Aminowm/pizzapitch/img/3d_rover.jpg

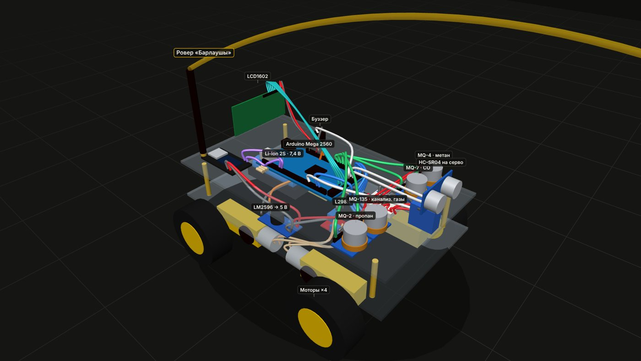
img/3d_rover.jpg
