Aminowm/pizzapitch/README.md

# Барлаушы — робот-разведчик газа

**Робот заходит первым. Человек — только когда безопасно.**
**Робот бірінші кіреді. Адам — тек қауіпсіз болғанда.**

Автономный ровер заезжает в канализационный колодец, коллектор, теплотрассу или подземную выработку раньше человека. Он меряет метан, угарный газ, канализационные газы и пропан и передаёт данные по LoRa на базу бригадира. Дальше данные идут в ноутбук по USB и на сайт через хотспот телефона. Если газ опасный, робот останавливается, включает сирену, отъезжает назад и ждёт решения человека.

Проект для **Pizza Pitch** (Ulytau Hub, Жезказган, 14 ноября 2026). Команда: Саян, Әмір, Әліби.

## Ссылки

| Что | Где |
|---|---|
| Сайт (лендинг + живая карточка) | https://aminowm.github.io/pizzapitch/ |
| Живой пульт (только просмотр) | https://aminowm.github.io/pizzapitch/live.html |
| Демо без железа | https://aminowm.github.io/pizzapitch/live.html#demo |
| Интерактивная 3D-схема | https://aminowm.github.io/pizzapitch/3d.html |
| QR-код на сайт | [`img/qr.png`](img/qr.png), карточка для жюри [`img/qr_card.png`](img/qr_card.png) |

## Что в репозитории

```
index.html, live.html, 3d.html, css/, js/, img/   сайт (GitHub Pages, корень репозитория)
firmware/rover_mega/rover_mega.ino                Arduino Mega: датчики MQ, моторы L298N, объезд, тревога, LCD
firmware/rover_lora/rover_lora.ino                LilyGO на ровере: мост Mega ↔ LoRa
firmware/base_lora/base_lora.ino                  LilyGO-база: LoRa → USB + Wi-Fi → MQTT → сайт
dashboard/index.html                              локальный пульт по USB (Chrome/Edge, без интернета)
docs/HARDWARE.md                                  схема подключения, питание, калибровка, план на 3 дня
docs/DEPLOY_SITE.md                               как включить сайт и проверить поток данных
docs/presentation_RU.pdf, presentation_KZ.pdf     презентация на русском и казахском
docs/idea_and_pitch_KZ.pdf                        жалпы идея, питч мәтіні, қиын сұрақтарға жауаптар
```

## Пины Arduino Mega (как собран робот)

| Что | Пины Mega |
|---|---|
| L298N | ENA=D5, IN1=D7, IN2=D8, IN3=D9, IN4=D10, ENB=D6 |
| MQ-4 / MQ-7 / MQ-135 / MQ-2 (AO) | A0 / A1 / A2 / A3 |
| Серво (сигнал) | D11 |
| HC-SR04 | TRIG=D12, ECHO=D13 |
| Буззер | D3 |
| LCD1602 с I2C | SDA=20, SCL=21 |
| LilyGO | TX1 (18) → делитель 3×10 кОм → GPIO34; LilyGO GPIO13 → RX1 (19) |

Питание: батарея 2S → L298N 12V → LM2596 (5,0 В на макетку: MQ, серво, HC-SR04, LCD, LilyGO) и Mega VIN. Общий GND.

## Как идут данные

1. Датчики MQ-4, MQ-7, MQ-135, MQ-2 → Arduino Mega (A0–A3)
2. Mega → LilyGO на ровере (UART, через делитель 5 → 3,3 В)
3. LoRa 433 МГц → LilyGO-база
4. База → ноутбук по USB (`dashboard/index.html`)
5. База → хотспот телефона «Barlaushy» → MQTT `broker.emqx.io`, канал `barlaushy/zhz1407`
6. Сайт подписан через WebSocket и обновляется в реальном времени

## Честно о прототипе

Датчики MQ недорогие, значения ppm оценочные, кислород они не измеряют. Прототип не является сертифицированным средством измерения. Промышленная версия: электрохимические сенсоры (O₂, H₂S, CO, CH₄), взрывозащищённый корпус, энкодеры, гусеницы, своё защищённое облако.
