Aminowm/pizzapitch/docs/presentation_KZ.pdf

P I Z Z A P I TC H · ЖЕ З Қ А З ҒА Н · 2 0 2 6 ЖЫ Л Ғ Ы 1 4
Қ А РА Ш А

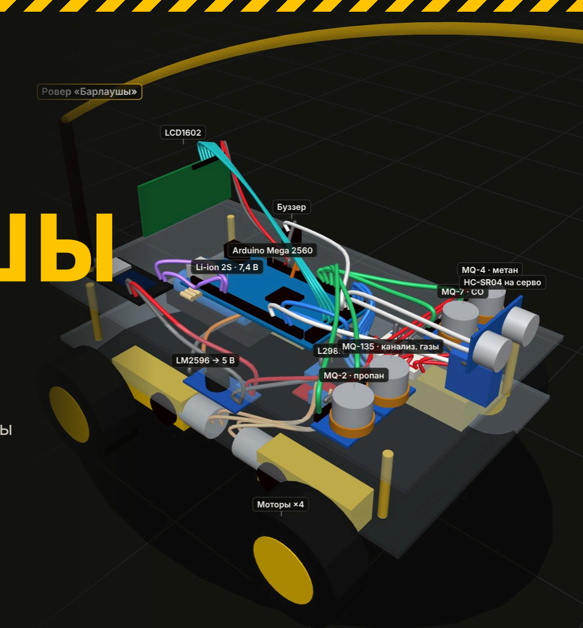
[picture p2: figure]

# БАРЛАУШЫ

Робот бірінші кіреді.
Адам — тек қауіпсіз болғанда.

Құдықтарға, коллекторларға және жерасты қазбаларына арналған автономды газ барлаушысы

Саян · Әмір · Әліби

Дереккөз: Kazinform · БАРЛАУШЫ · 2

ЖЕ З Қ А З ҒА Н · 2 0 2 6 ЖЫ Л Ғ Ы 2 0 М А М Ы Р · А Б А Й — Ч Е ХО В КӨ Ш Е Л Е Р І

# Біздің қалада екі жұмысшы кәріз құдығын тазалап жатты

## Газ шықты — болжам бойынша метан. Бір адам қаза тапты. Екіншісі

өте ауыр жағдайда ауруханаға жеткізілді.

Газ көзге көрінбейді, метанның иісі жоқ. Оны тек құрал арқылы — немесе өз
өкпеңмен — білуге болады.

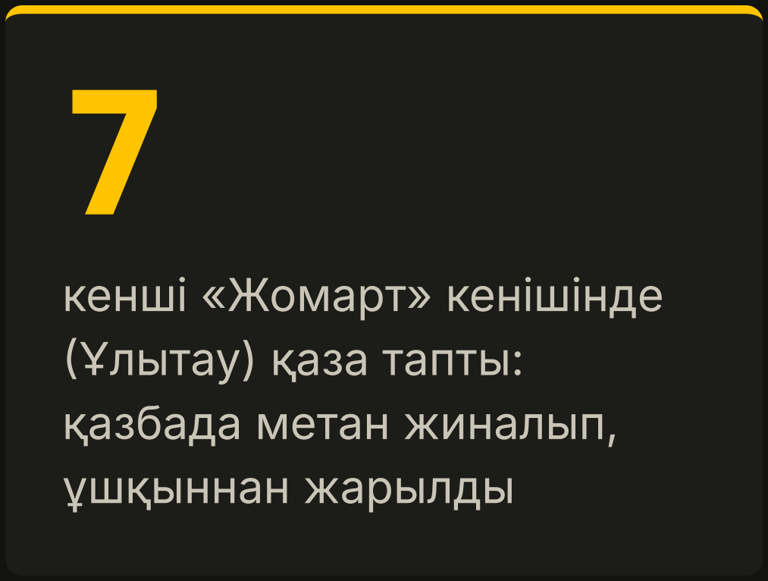
[picture p3: figure]
кенші «Жомарт» кенішінде (Ұлытау) қаза тапты: қазбада метан жиналып, ұшқыннан жарылды
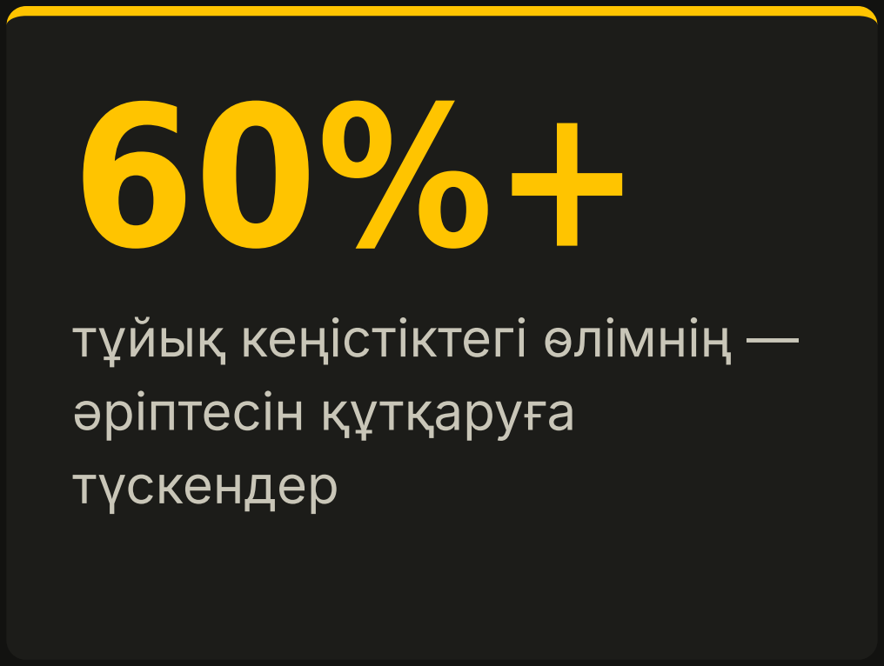
[picture p4: figure]
тұйық кеңістіктегі өлімнің — әріптесін құтқаруға түскендер

Дереккөздер: Forbes.kz, 24.kz («Жомарт», 2025) · NIOSH 86-110, OHS Online · БАРЛАУШЫ · 3

М Ә С Е Л Е

# ГАЗДЫ ӨКПЕМЕН ТЕКСЕРЕДІ

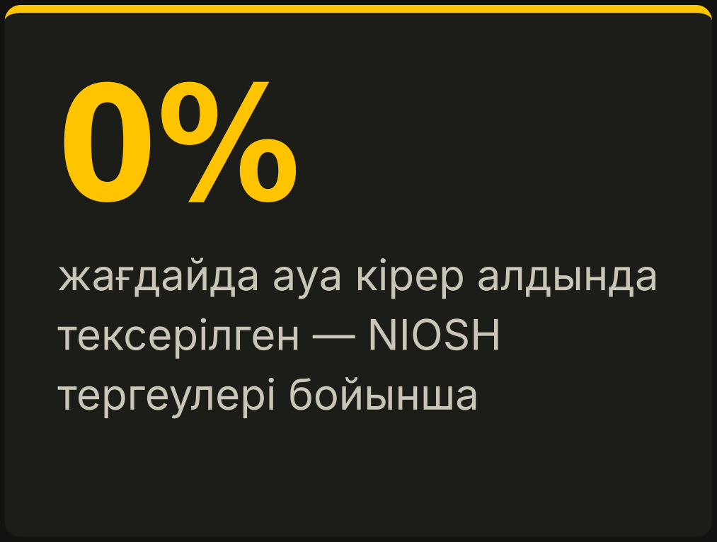
[picture p5: figure]
жағдайда ауа кірер алдында тексерілген — NIOSH тергеулері бойынша

# ҚАУІП ТЫМ КЕШ БАЙҚАЛАДЫ

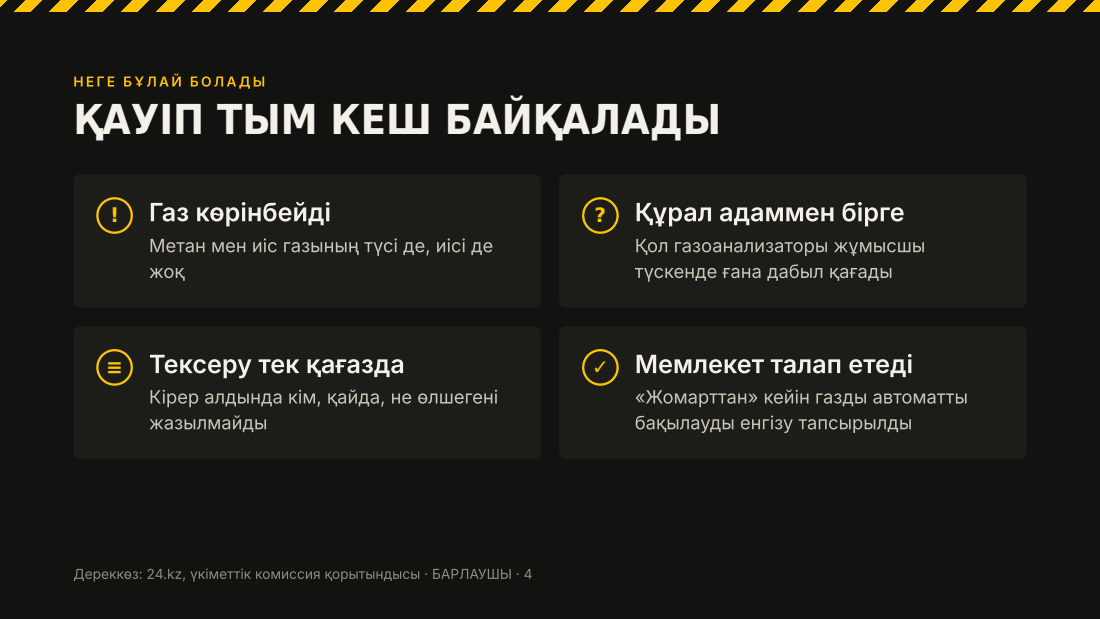
[picture p6: page 4]
Газ көрінбейді; Құрал адаммен бірге

Метан мен иіс газының түсі де, иісі де
жоқ

Қол газоанализаторы жұмысшы
түскенде ғана дабыл қағады

≡ Тексеру тек қағазда
Кірер алдында кім, қайда, не өлшегені
жазылмайды

✓ Мемлекет талап етеді
«Жомарттан» кейін газды автоматты
бақылауды енгізу тапсырылды

Дереккөз: 24.kz, үкіметтік комиссия қорытындысы · БАРЛАУШЫ · 4

# БАРЛАУШЫ БІРІНШІ КІРЕДІ

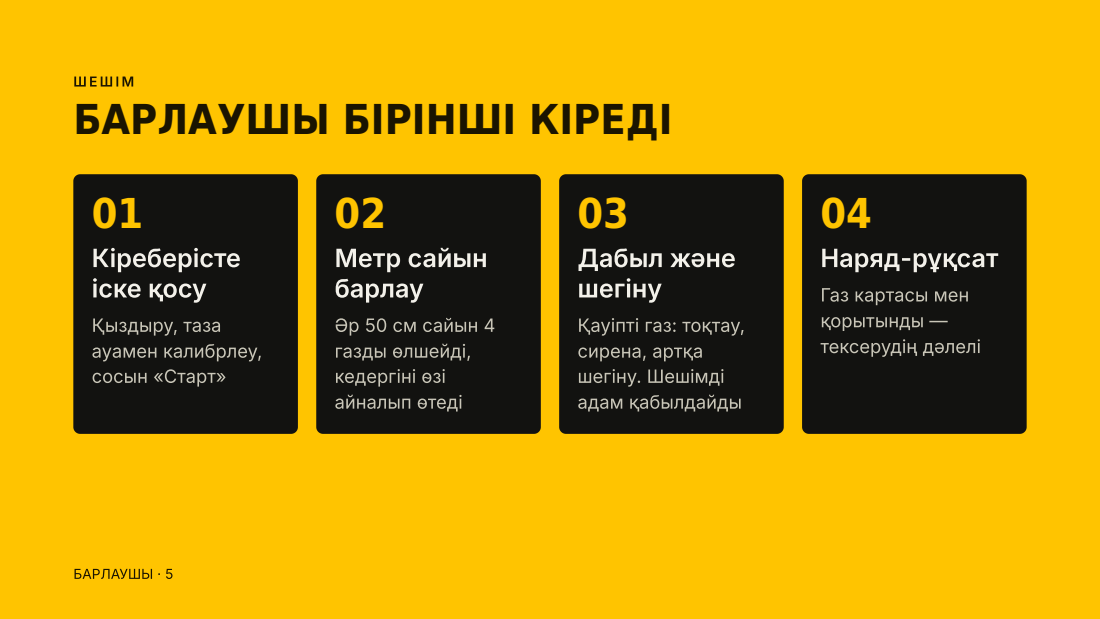
[picture p7: page 5]
БАРЛАУШЫ · 5; Кіреберісте іске қосу; Қыздыру, таза ауамен калибрлеу, сосын «Старт»; Метр сайын барлау; Дабыл және шегіну; Наряд-рұқсат

Газ картасы мен
қорытынды —
тексерудің дәлелі

Әр 50 см сайын 4
газды өлшейді,
кедергіні өзі
айналып өтеді

Қауіпті газ: тоқтау,
сирена, артқа
шегіну. Шешімді
адам қабылдайды

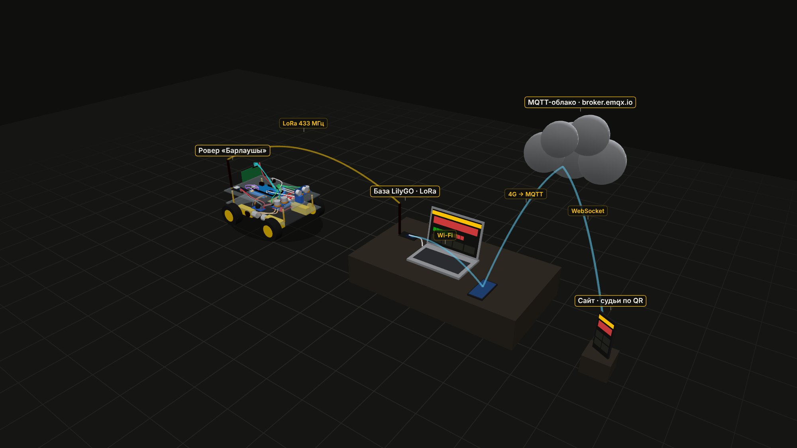
[picture p8: figure]

Интерактивті 3D-модель: aminowm.github.io/pizzapitch/3d.html · БАРЛАУШЫ · 6

Қ А Л А Й ЖҰ М Ы С І С Т Е Й Д І

# ДАТЧИКТЕН ТЕЛЕФОНҒА ДЕЙІН

1 MQ датчиктері → Arduino Mega

2 Mega → LilyGO сым арқылы 3 LoRa 433 МГц радиосы → база

4 База → ноутбук USB арқылы

5 Телефон хотспоты → MQTT бұлты 6 Кез келген телефондағы сайт

Р О Б ОТ Т Ы Ң І Ш І Н Д Е

# ҚОЛЖЕТІМДІ БӨЛШЕКТЕРДЕН ЖИНАЛҒАН

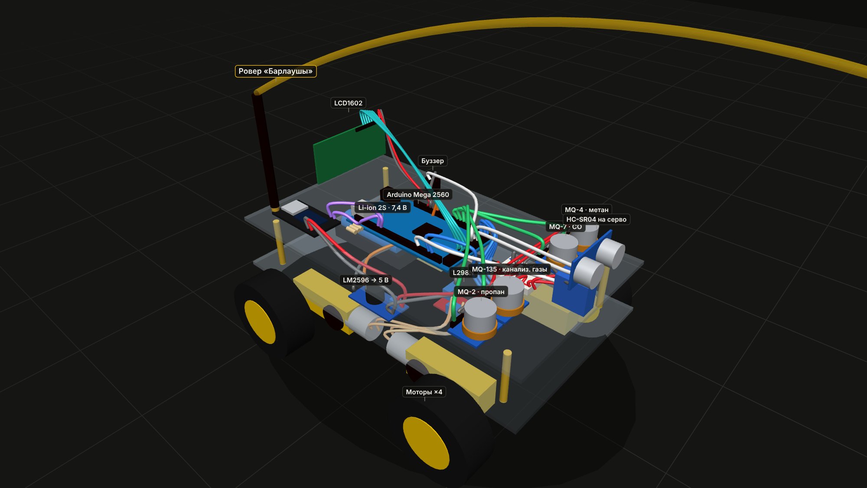
[picture p9: figure]

4 MQ датчигі
метан, CO, кәріз газдары, пропан
Arduino Mega 2560
логика, моторлар, сирена
LilyGO LoRa 433 МГц
базамен радиобайланыс
Серводағы HC-SR04
қабырғаны көреді, айналып өтеді
L298N + 4 мотор
толық жетек
Li-ion 2S + LM2596
моторларға 7,4 В, электроникаға 5 В

Д Ә Л Қ А З І Р

# ТІРІ ДЕМО

## Робот туннельмен жүреді → газды табады → сирена және шегіну

Деректерді өз телефоныңыздан бақылаңыз: aminowm.github.io/pizzapitch

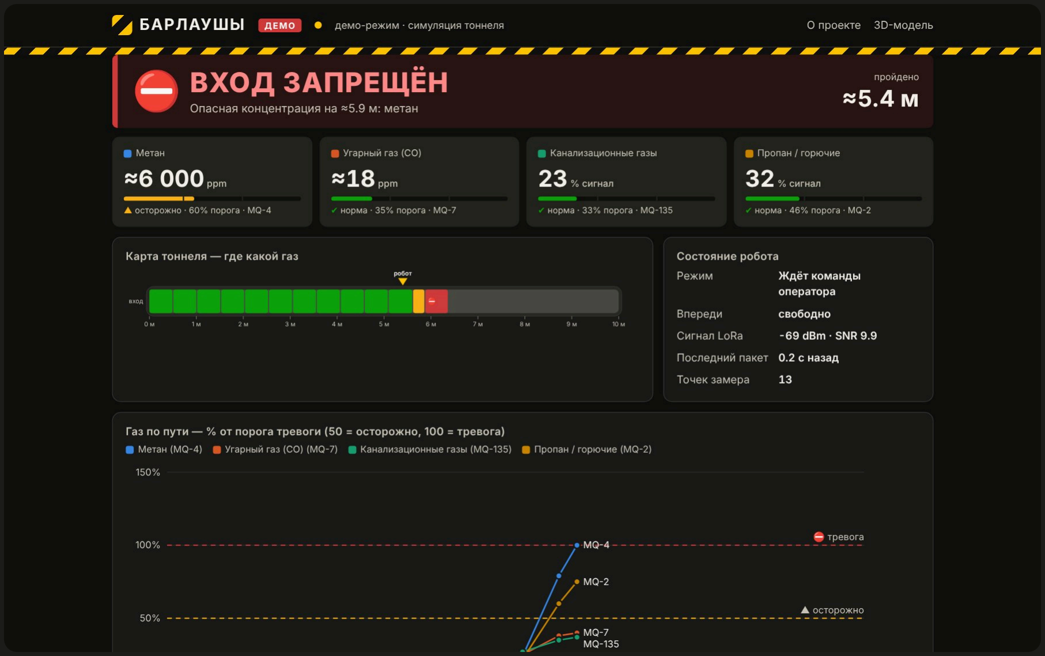
[picture p10: figure]

Демо-режимдегі пульттің скриншоты · БАРЛАУШЫ · 9

Н Ә Т ИЖЕ

# БРИГАДИР НЕ КӨРЕДІ

✓ Қорытынды: кіруге бола ма, жоқ па

▲ Туннель метрлері бойынша газ картасы

≡ PDF наряд-рұқсат — тексерудің дәлелі

◎ Интернетсіз — USB арқылы, интернетпен — сілтеме арқылы

# БАРЛАУШЫ КІМГЕ КЕРЕК

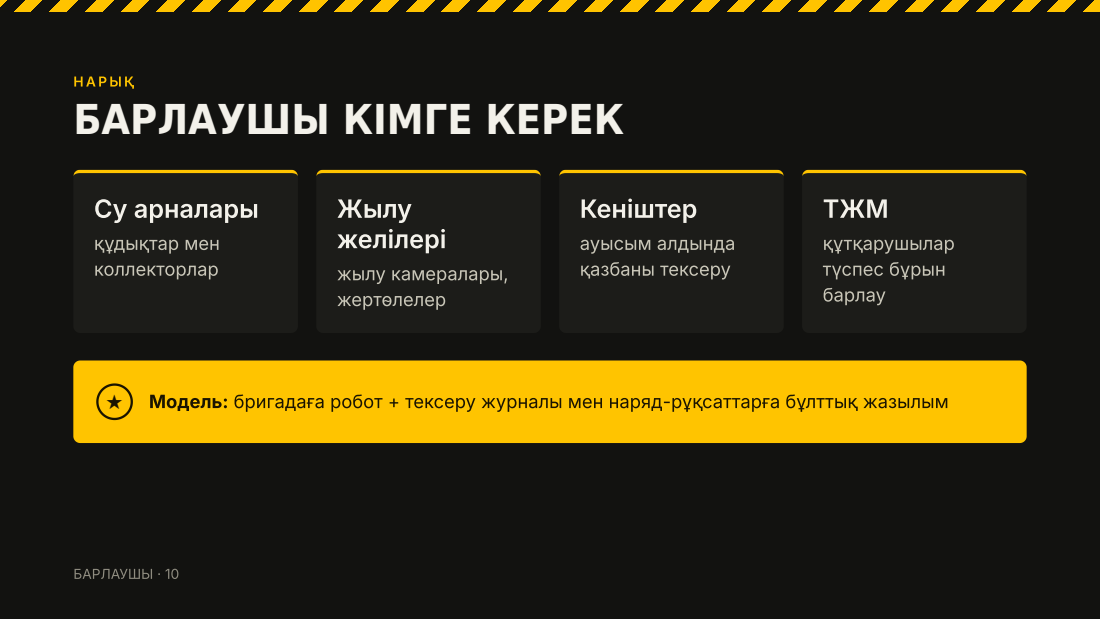
[picture p11: page 10]
Су арналары; құдықтар мен коллекторлар; Жылу желілері; жылу камералары, жертөлелер; Кеніштер; ауысым алдында қазбаны тексеру; ТЖМ; құтқарушылар түспес бұрын барлау

★ Модель: бригадаға робот + тексеру журналы мен наряд-рұқсаттарға бұлттық жазылым

Не | Қазіргі прототип | Өнеркәсіптік нұсқа
Датчиктер | MQ, ppm шамамен | электрохимия: O₂, H₂S, CO, CH₄
Корпус | ашық шасси | жарылыстан қорғалған — ұшқынсыз
Қашықтық | жүру уақыты бойынша | дөңгелек энкодерлері
Өтімділік | дөңгелектер | шынжыр табан
Бұлт | ашық MQTT | өз қорғалған бұлтымыз

П Р ОТОТ И П ТУРА Л Ы А Д А Л

# ҚАЗІР → ӨНЕРКӘСІПТІК НҰСҚА

# БАРЛАУШЫНЫ КІМ ЖАСАДЫ

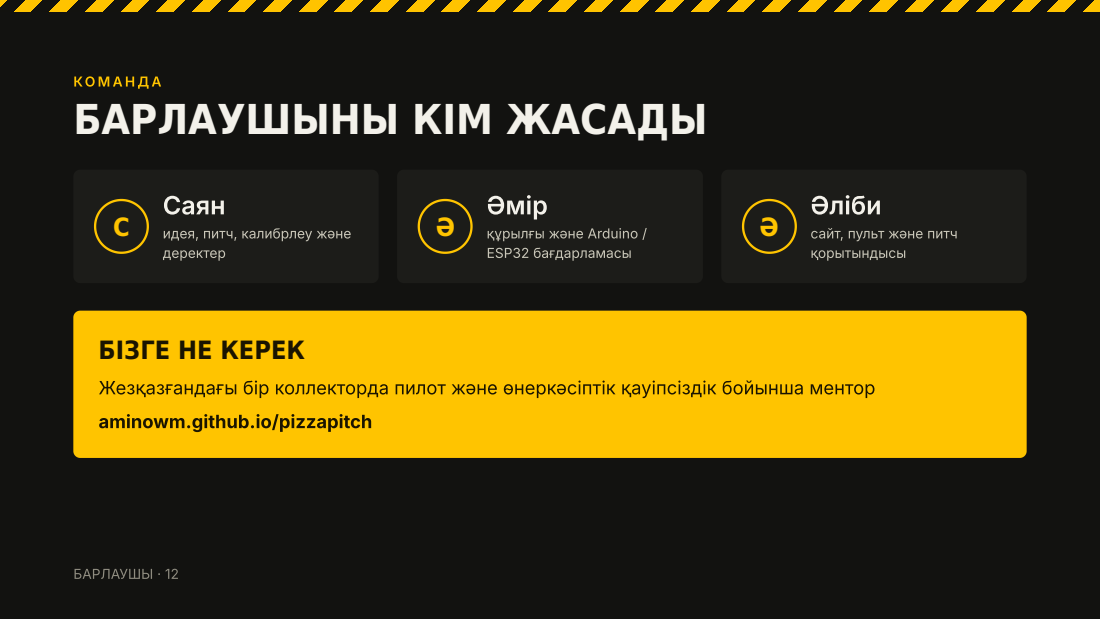
[picture p12: page 12]
Саян; Әмір; Әліби

идея, питч, калибрлеу және
деректер

құрылғы және Arduino /
ESP32 бағдарламасы

сайт, пульт және питч
қорытындысы

БІЗГЕ НЕ КЕРЕК

Жезқазғандағы бір коллекторда пилот және өнеркәсіптік қауіпсіздік бойынша ментор
aminowm.github.io/pizzapitch
