Aminowm/pizzapitch/docs/presentation_RU.pdf

P I Z Z A P I TC H · ЖЕ З К А З ГА Н · 1 4 Н О Я Б Р Я 2 0 2 6

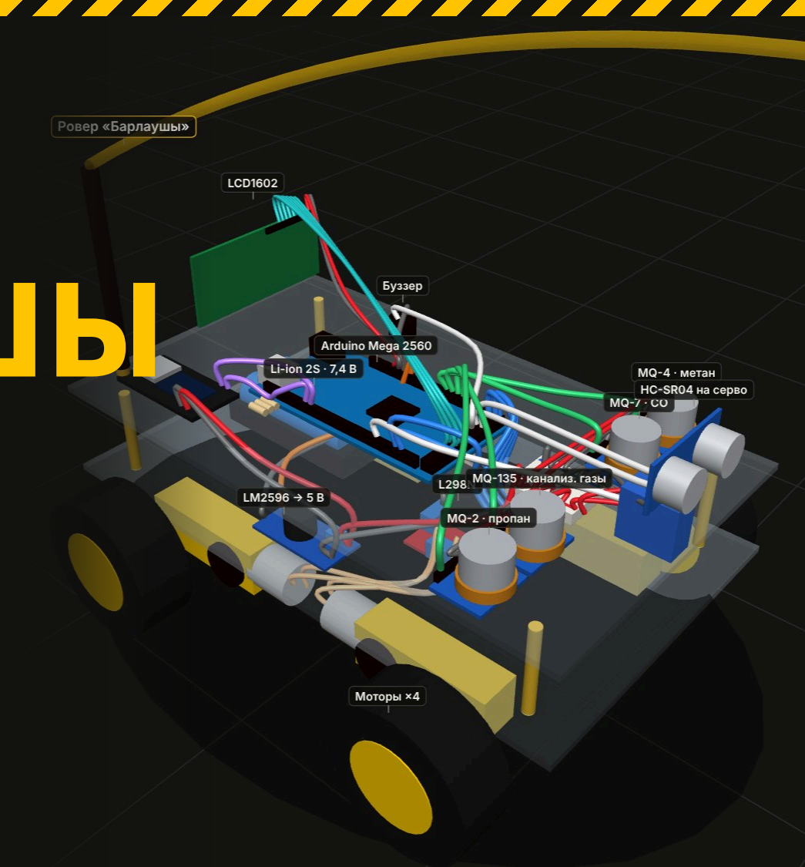
[picture p13: figure]

# БАРЛАУШЫ

Робот заходит первым.
Человек — только когда безопасно.

Автономный разведчик газа для колодцев, коллекторов и подземных выработок

Саян · Әмір · Әліби

Источник: Kazinform · БАРЛАУШЫ · 2

ЖЕ З К А З ГА Н · 2 0 М А Я 2 0 2 6 · У Л . А Б А Я — Ч Е ХО В А

# Двое рабочих чистили канализационный колодец в нашем городе

## Выброс газа — предположительно метан. Один погиб. Второго

увезли в крайне тяжёлом состоянии.

Газ не видно, у метана нет запаха. Узнать о нём можно только прибором — или собой.

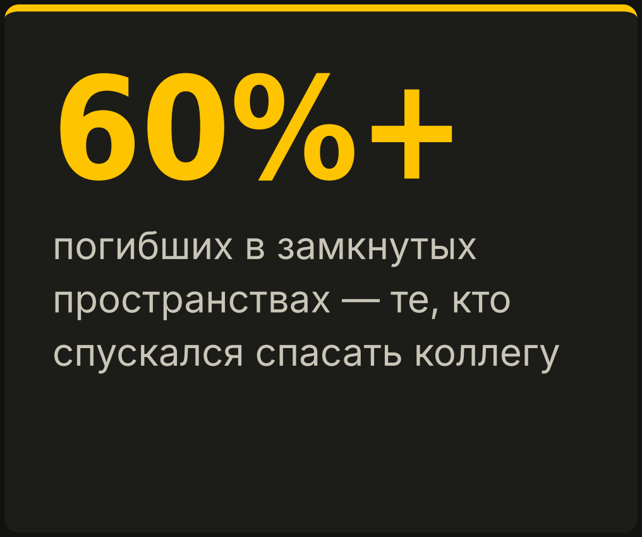
[picture p14: figure]
погибших в замкнутых пространствах — те, кто спускался спасать коллегу
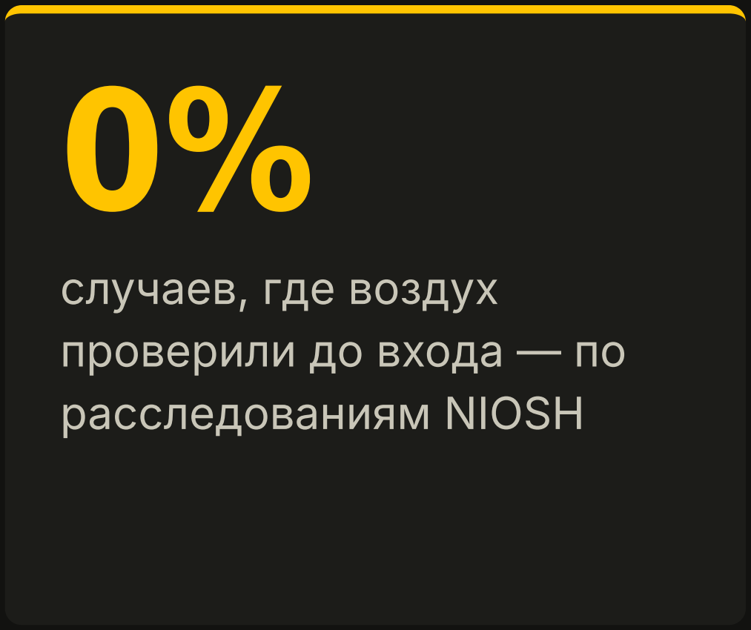
[picture p15: figure]
случаев, где воздух проверили до входа — по расследованиям NIOSH

Источники: Forbes.kz, 24.kz (рудник «Жомарт», 2025) · NIOSH 86-110, OHS Online · БАРЛАУШЫ · 3

П Р О Б Л Е М А

# ГАЗ ПРОВЕРЯЮТ ЛЁГКИМИ

7

горняков погибли на
руднике «Жомарт» в
Улытау: метан скопился в
выработке и взорвался от
искры

# ОПАСНОСТЬ ВИДНА СЛИШКОМ ПОЗДНО

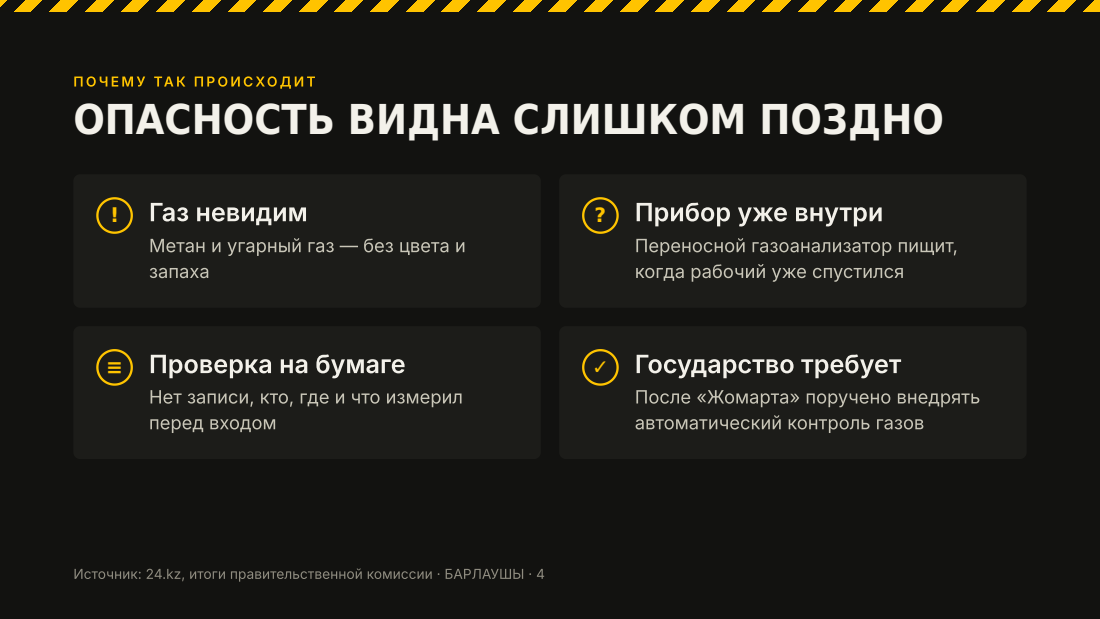
[picture p16: page 4]
Газ невидим; Прибор уже внутри

Метан и угарный газ — без цвета и
запаха

Переносной газоанализатор пищит,
когда рабочий уже спустился

≡ Проверка на бумаге
Нет записи, кто, где и что измерил
перед входом

✓ Государство требует
После «Жомарта» поручено внедрять
автоматический контроль газов

Источник: 24.kz, итоги правительственной комиссии · БАРЛАУШЫ · 4

# БАРЛАУШЫ ЗАХОДИТ ПЕРВЫМ

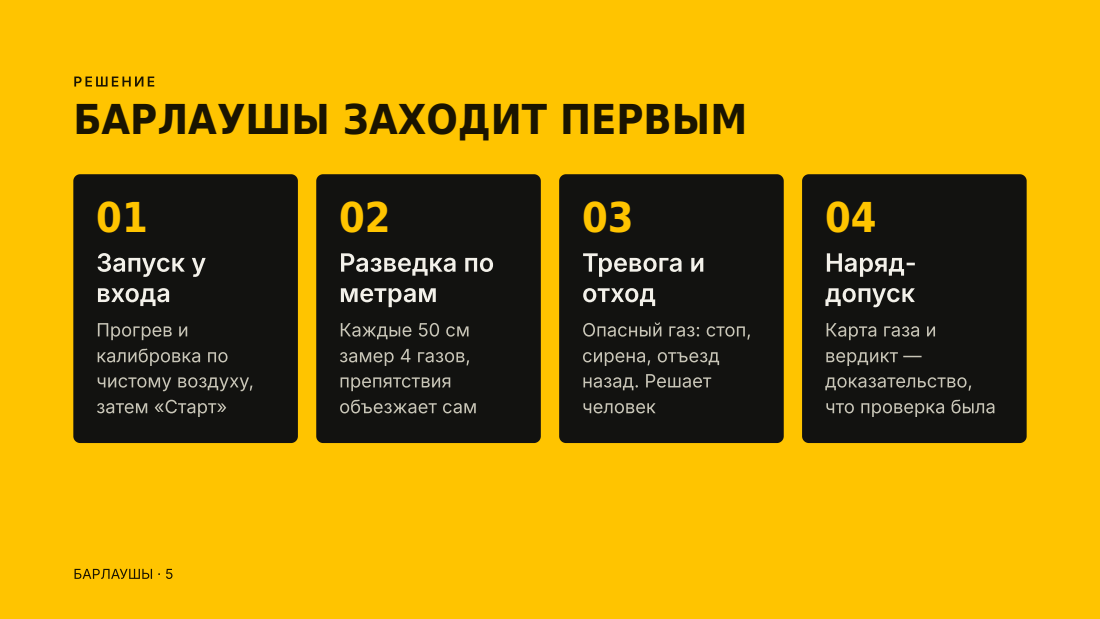
[picture p17: page 5]
БАРЛАУШЫ · 5; Запуск у входа; Прогрев и калибровка по чистому воздуху, затем «Старт»; Разведка по метрам; Каждые 50 см замер 4 газов, препятствия объезжает сам; Тревога и отход; Наряд- допуск

Опасный газ: стоп,
сирена, отъезд
назад. Решает
человек

Карта газа и
вердикт —
доказательство,
что проверка была


Интерактивная 3D-модель: aminowm.github.io/pizzapitch/3d.html · БАРЛАУШЫ · 6

К А К ЭТО РА Б ОТА Е Т

# ОТ ДАТЧИКА ДО ТЕЛЕФОНА СУДЬИ

1 Датчики MQ → Arduino Mega

2 Mega → LilyGO по проводу 3 Радио LoRa 433 МГц → база

4 База → ноутбук по USB

5 Хотспот телефона → облако MQTT 6 Сайт на любом телефоне

В Н У Т Р И Р О Б ОТА

# СОБРАНО ИЗ ДОСТУПНЫХ ДЕТАЛЕЙ


4 датчика MQ
метан, CO, канализационные газы, пропан
Arduino Mega 2560
логика, моторы, сирена
LilyGO LoRa 433 МГц
радиосвязь с базой
HC-SR04 на серво
видит стены и объезжает
L298N + 4 мотора
полный привод
Li-ion 2S + LM2596
7,4 В на моторы, 5 В на электронику

П Р Я М О С Е Й Ч АС

# ЖИВОЕ ДЕМО

## Робот едет по тоннелю → находит газ → сирена и отход

Следите за данными со своего телефона: aminowm.github.io/pizzapitch


Скриншот пульта в демо-режиме · БАРЛАУШЫ · 9

Р Е ЗУ Л ЬТАТ

# ЧТО ВИДИТ БРИГАДИР

✓ Вердикт: вход разрешён или запрещён

▲ Карта газа по метрам тоннеля

≡ Наряд-допуск в PDF —
доказательство проверки

◎ Без интернета — по USB, с интернетом — по ссылке

# КОМУ НУЖЕН БАРЛАУШЫ

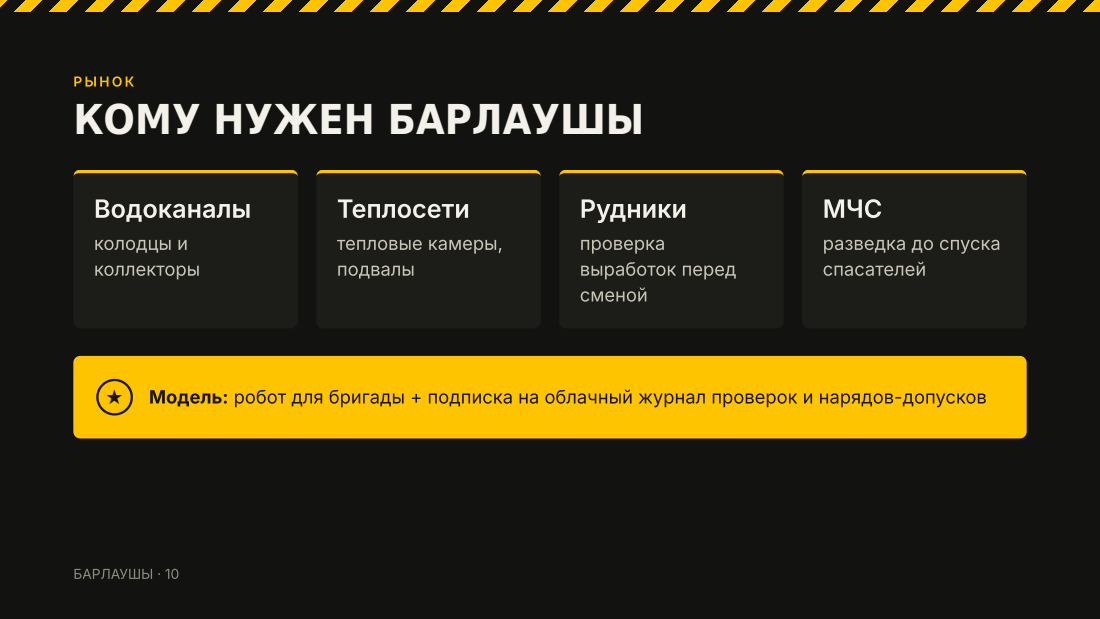
[picture p18: page 10]
Водоканалы; колодцы и коллекторы; Теплосети; тепловые камеры, подвалы; Рудники; проверка выработок перед сменой

МЧС
разведка до спуска
спасателей

★ Модель: робот для бригады + подписка на облачный журнал проверок и нарядов-допусков

Что | Прототип сейчас | Промышленная версия
Датчики | MQ, оценочные ppm | электрохимия: O₂, H₂S, CO, CH₄
Корпус | открытое шасси | взрывозащищённый — без искры
Расстояние | по времени езды | энкодеры колёс
Проходимость | колёса | гусеницы
Облако | публичный MQTT | своё защищённое облако

Ч Е С Т Н О О П Р ОТОТ И П Е

# СЕЙЧАС → ПРОМЫШЛЕННАЯ ВЕРСИЯ

# КТО СДЕЛАЛ БАРЛАУШЫ

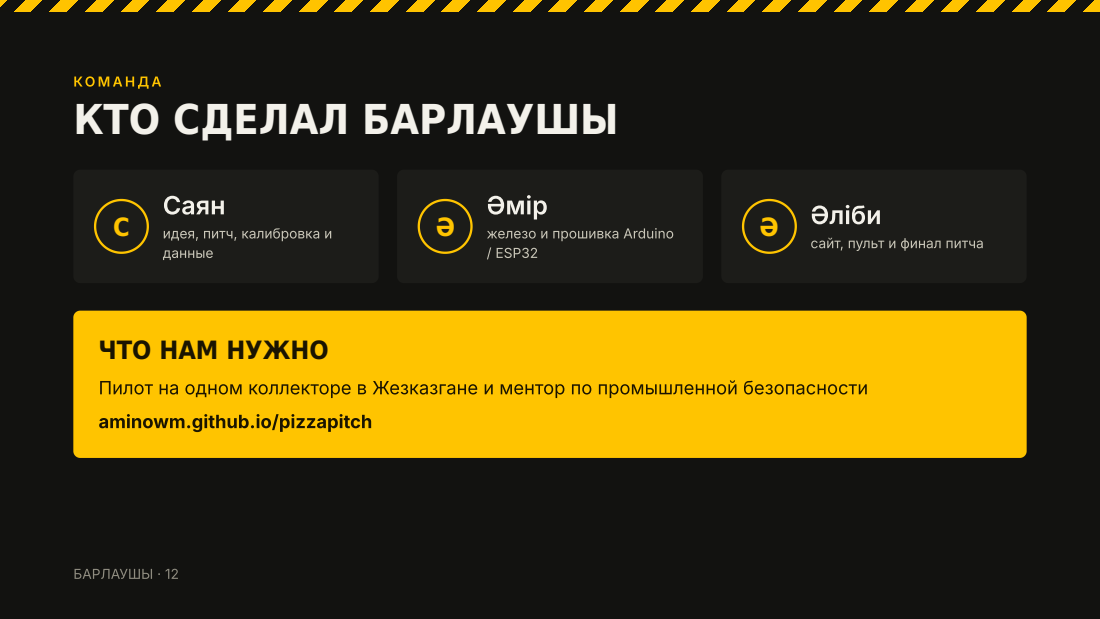
[picture p19: page 12]
Саян; Әмір; Әліби

идея, питч, калибровка и
данные

железо и прошивка Arduino
/ ESP32

сайт, пульт и финал питча

ЧТО НАМ НУЖНО

Пилот на одном коллекторе в Жезказгане и ментор по промышленной безопасности
aminowm.github.io/pizzapitch
