Aminowm/pizzapitch/img/qr.png

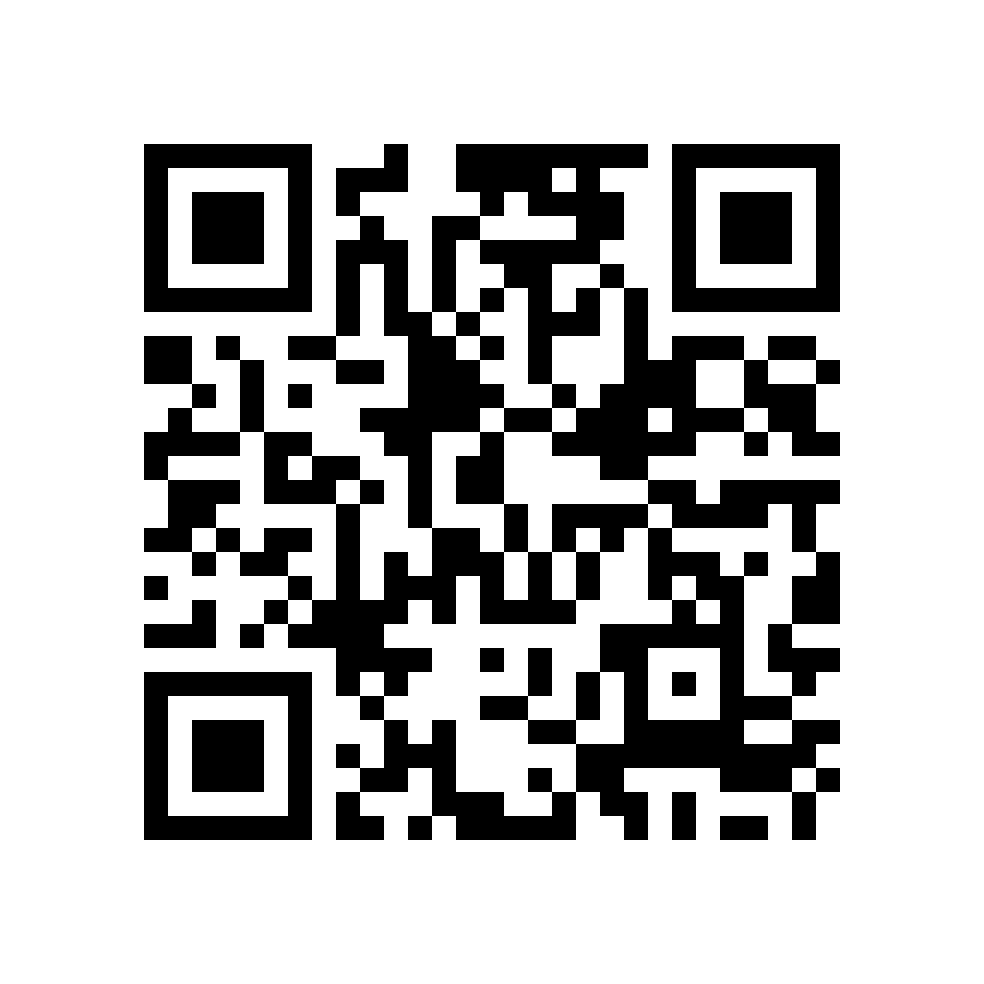
img/qr.png
