Aminowm/pizzapitch/img/qr_card.png

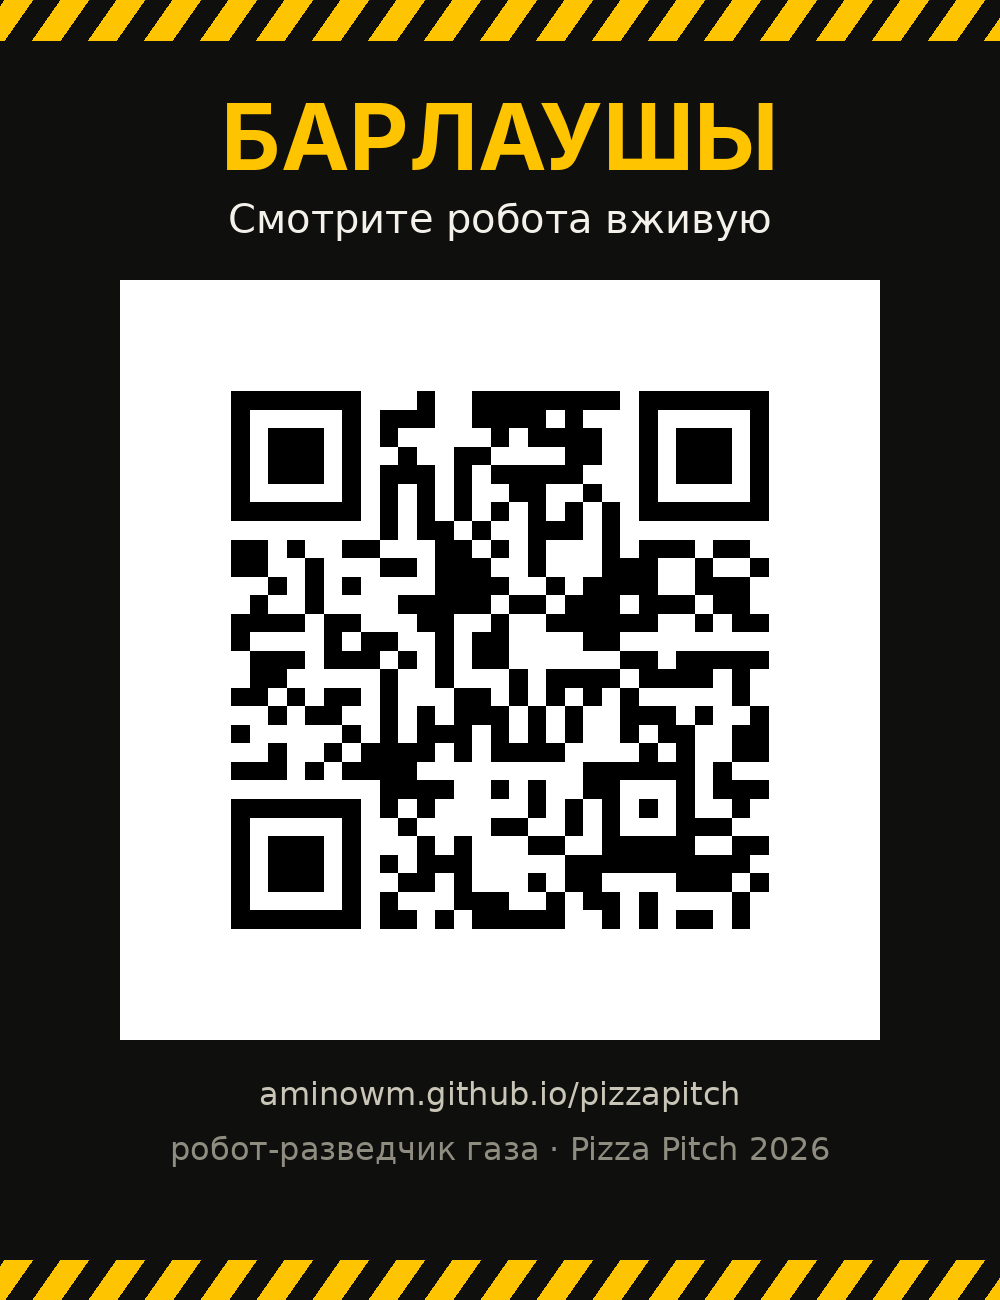
img/qr_card.png
