Aminowm/pizzapitch/(commit log)

2026-11-11 Барлаушы: сайт, прошивки, пульт и презентации
    Робот-разведчик газа для Pizza Pitch (Жезказган, 14.11.2026):
    - сайт для GitHub Pages: лендинг, живой пульт (MQTT), 3D-схема, QR
    - прошивки: Arduino Mega, LilyGO ровер, LilyGO база (LoRa + Wi-Fi/MQTT)
    - локальный пульт по USB
    - docs: схема подключения, инструкция, презентации RU/KZ, питч KZ
    Claude-Session: https://claude.ai/code/session_01GKpcXqEzBGoEbawLGJpuqs
2026-11-11 Прошивка Mega под фактическую распиновку робота
    L298N на D5/D7/D8/D9/D10/D6, серво D11, HC-SR04 D12/D13,
    буззер D3, LCD1602 через I2C (20/21). Таблица пинов в README.
    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
2026-11-11 LoRa: частота 868 МГц под модули 868/915
    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
2026-11-12 LoRa test sketch (same file for both LilyGO boards)
    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
2026-11-12 lora_test: works without screen, LED shows link status
    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
2026-11-12 Rename pin constants to avoid clash with esp32 core TTGO macros
    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
    [base_lora.ino, lora_test.ino, rover_lora.ino]
2026-11-13 Dashboard: cable mode (Mega via USB, no LoRa) + laptop forwards data to website
    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
2026-11-13 Cable-only Mega firmware with beginner comments + TEST self-check button
    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
2026-11-13 Fix Arduino prototype error (setMode takes int)
    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
    [barlaushy_cable.ino]
2026-11-13 Re-init LCD whenever motors stop (motor noise garbles I2C LCD)
    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
    [barlaushy_cable.ino]
2026-11-13 Sonar: ignore <3cm noise readings, USE_SONAR switch
    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
    [barlaushy_cable.ino]
2026-11-13 Re-init LCD every 3s while motors run
    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
2026-11-13 Simple motor test sketch
    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
